chocokiwi0404/audioamp/Project_Report.pdf

# Audio Amplifier Design Report

### Kavya Pandey - 2024102001, Vedant Zope - 2024102003

## Contents

1 Introduction | 3
2 Differential Amplifier (Pre-Amplifier Stage) | 3
3 Common-Emitter (CE) Gain Stage | 10
4 Filter Stage (20 Hz–20 kHz) | 17
5 Power Amplifier Stage | 24

6 Overall Performance and Analysis | 30
7 Conclusion | 32

## 1 Introduction

This project involves the design and construction of a four-stage audio amplifier capable of driving a 10 Ω speaker load with approximately 0.7W of power. The design prioritizes minimal Total Harmonic Distortion (THD) and a flat frequency response within the audible range of 20 Hz to 20 kHz.

## 2 Differential Amplifier (Pre-Amplifier Stage)

### 2.1 Circuit Overview and Purpose

The Pre-amplifier uses a dual-input unbalanced output differential topology. Its primary role is to enhance weak signals (10 mV to 20 mVpp) to line level while maintaining a high Signal-to-Noise Ratio (SNR) and suppressing common-mode noise.

### 2.2 Impedance Finding

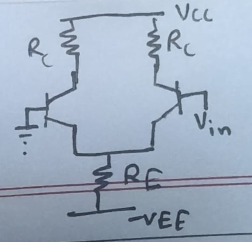
[picture p5: figure]

Figure 1: Circuit diagram

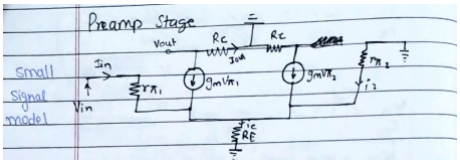
[picture p6: figure]

Figure 2: Small signal model of differential amplifier

The input impedance is defined as

Zin =

Vin

Iin

(1)

From the small signal model,

Iin =

Vin − VE

rπ1

(1)

0 − VE

rπ2

= −I2 | (2)

Assuming

gmvπ1 ≫ I1 | and | gmvπ2 ≫ I2

Then,

VE = gm(vπ1 + vπ2)RE | (2)

Since

vπ = i rπ

we obtain

VE = gmRE(Iin + I2)rπ | (3)

From equation (1),

Iin =

Vin
rπ
− gmRE(Iin + I2) | (4)

From equation (2),

I2 = −

gm(Iin + I2)
RE

(5)

Solving for I2,

I2 = −

gmIinRE
1 + gmRE

(6)

Substituting the value of I2,

Vin
rπ

= Iin
1 + gmIinRE −

gmIinRE
1 + gmIinRE
(7)

Let

α = gmIinRE | and | α ≪ 1

Then,

Vin

Iin

= rπ

1 + α −

α
1 + α
(8)

For α ≪ 1,

Vin

Iin

≈ rπ | (9)

Hence,

Zin = rπ

which is the input resistance.

Output Resistance

Rout =

Vout

Iout
Since

Vout = IoutRC

we obtain

Rout = RC

### 2.3 Gain Derivation

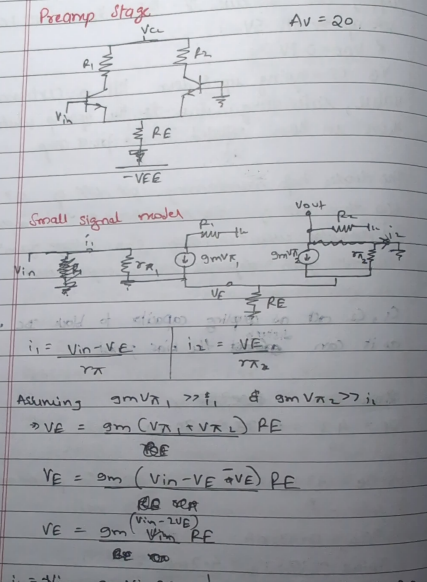
[picture p7: figure]

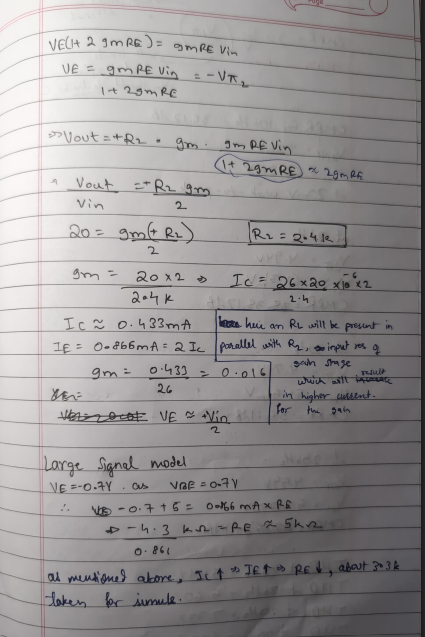
[picture p8: figure]

### 2.4 CMRR and Impedance Analysis

The Common Mode Rejection Ratio (CMRR) is critical for noise immunity:

CMRRabs = gmRE | (10)

With RE = 3.3 kΩ, the theoretical CMRR is 38.4 dB. The input impedance is high (Rin =

2β
gm

), and output impedance is approximately RC.

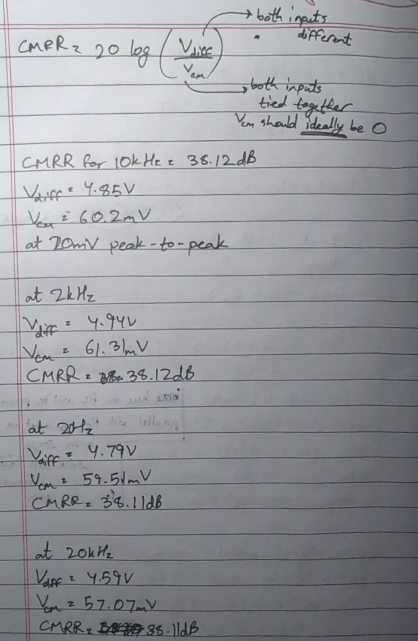
[picture p9: figure]

Figure 3: CMRR values for different frequencies

### 2.5 Simulation Validation

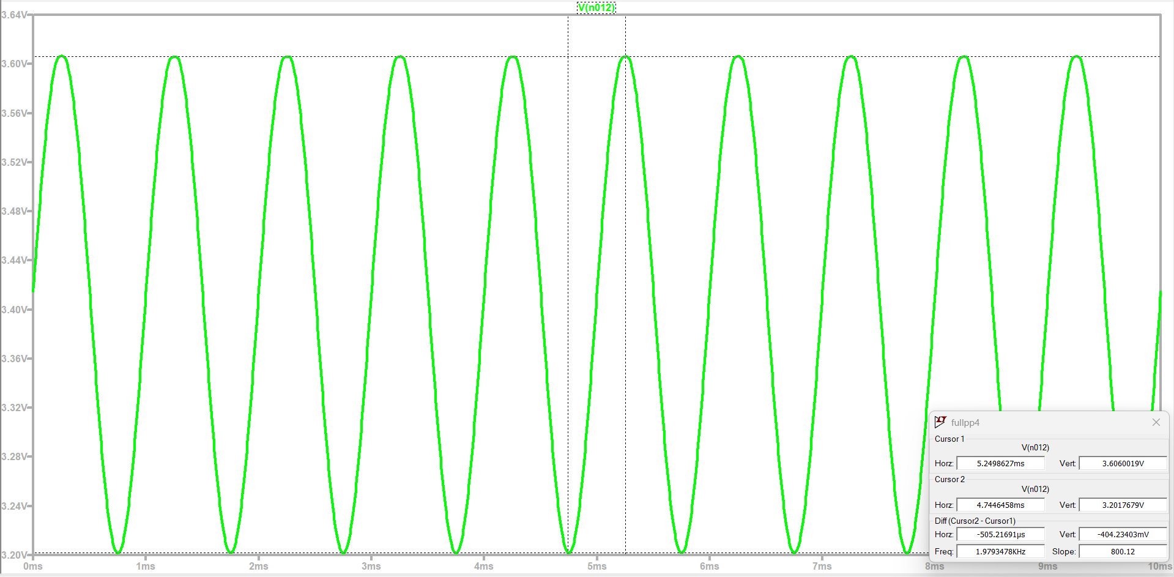
[picture p10: figure]

Figure 4: LTspice transient waveform — Differential Amplifier stage.

### 2.6 Measured LTspice Parameters — Pre-Amplifier

Table 1: LTspice Measured Parameters for Differential Stage

Parameter | Simulated Value
Collector Current (IC1, IC2) | 660 µA
Quiescent Output Voltage (Vout,DC) | 3.41 V
Differential Gain (Ad) | 24.2
Common Mode Gain (Ac) | 60.2
CMRR (Simulated) | 38.12 dB

### 2.7 Hardware Implementation

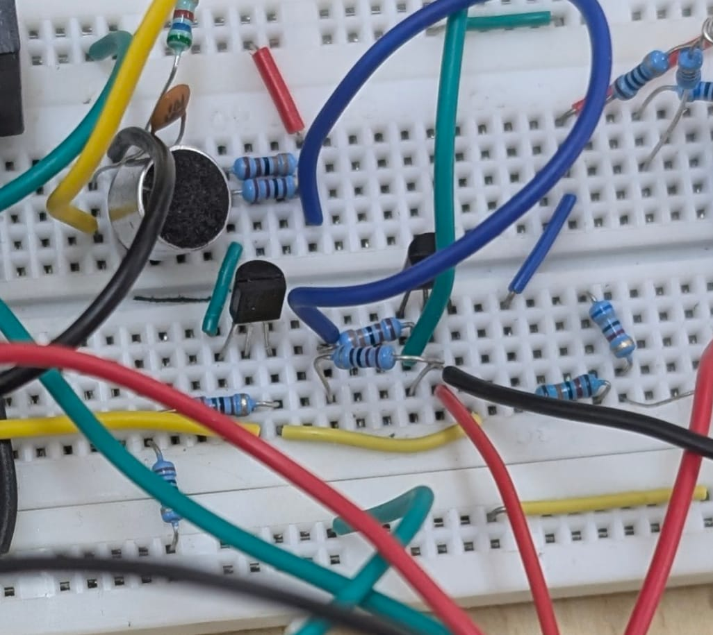
[picture p11: figure]

Figure 5: Hardware circuit of differential amplifier

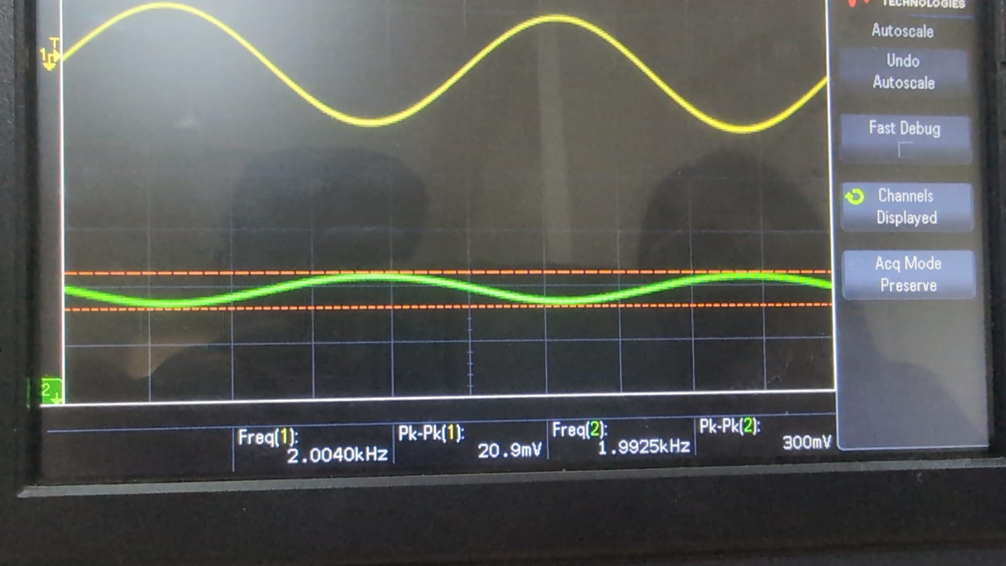
[picture p12: figure]

Figure 6: Waveform

## 3 Common-Emitter (CE) Gain Stage

### 3.1 Purpose and Biasing

The gain stage boosts the signal to a level suitable for the power amplifier. It utilizes voltage divider biasing to ensure the transistor remains in the active region throughout the signal cycle.

### 3.2 Impedence finding

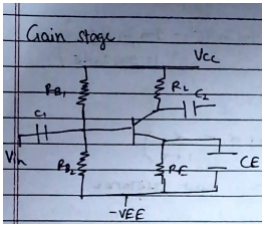
[picture p13: figure]

Figure 7: Circuit digram of Gain stage

### 3.2.1 Output Resistance

To find the output resistance, set the input signal to zero.

Vin = 0

Hence,

gmvπ = 0

Therefore the controlled current source becomes zero and the output current flows only through RL.

Iout =

Vout
RL
Thus,

Rout =

Vout

Iout

= RL

For the given circuit,

Rout = RL

Small Signal Model

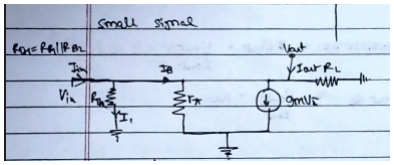
[picture p14: figure]

Figure 8: Small signal model

RT h = RB1 ∥ RB2

Current through RT h:

I1 =

Vin

RT h
Base current through rπ:

I2 =

Vin
rπ
Total current entering the node is

I = I1 + I2

I =

Vin

RT h

+

Vin
rπ

Input Resistance of Gain Stage

The input resistance is

Rin = RB1 ∥ RB2 ∥ rπ

Since

rπ ≫ RB1, RB2

we approximate

Rin ≈ RB1 ∥ RB2

RB1 ∥ RB2 =

RB1RB2

RB1 + RB2
From the design,

RB1RB2

RB1 + RB2

≈ 10RE (from preamp condition)

Given

RB1RB2

RB1 + RB2

≈ 50 kΩ

### 3.3 Small-Signal Gain Derivation

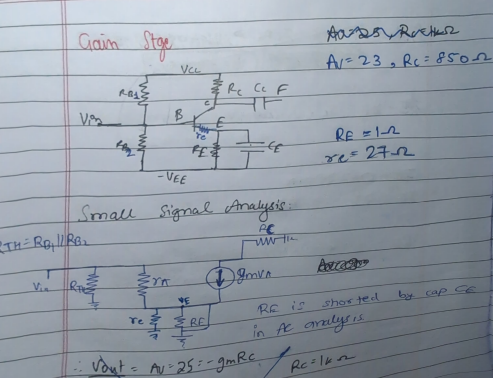
[picture p15: figure]

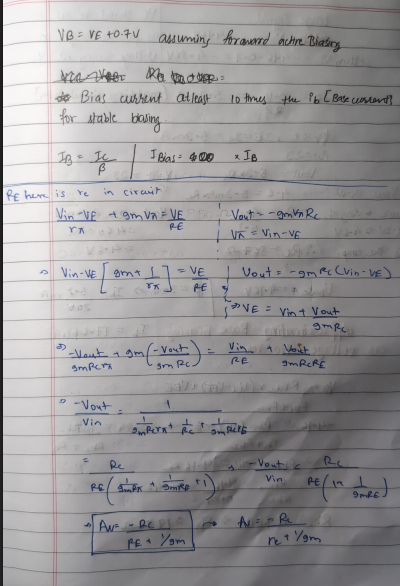
[picture p16: figure]
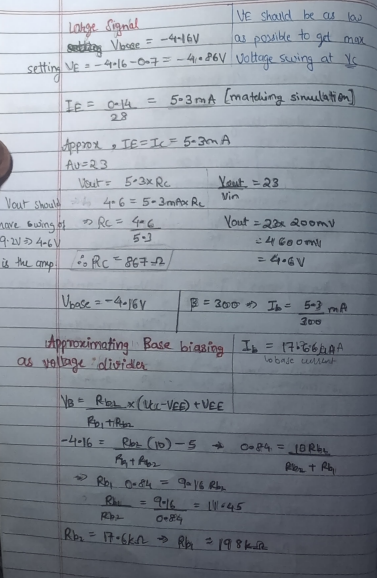
[picture p17: page 15]

### 3.4 Integration and Verification with Stage 1

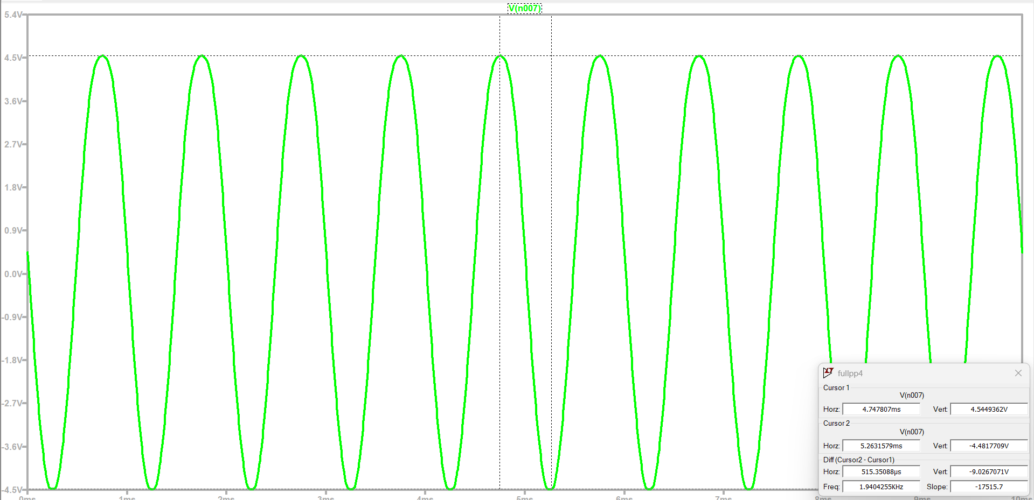
[picture p18: figure]

Figure 9: LTspice waveform — Stages 1 & 2 cascaded output.

### 3.5 Measured LTspice Parameters — CE Stage

Table 2: LTspice Measured Parameters for Gain Stage

Parameter | Simulated Value
Base Voltage (VB) | −4.16 V
Collector-Emitter Voltage (VCEQ) | 5.31 V
Collector Quiescent Current (ICQ) | 5.35 mA
Voltage Gain (Av) | 26 dB
Input Impedance (Zin) | 15.63 kΩ

### 3.6 Hardware Implementation

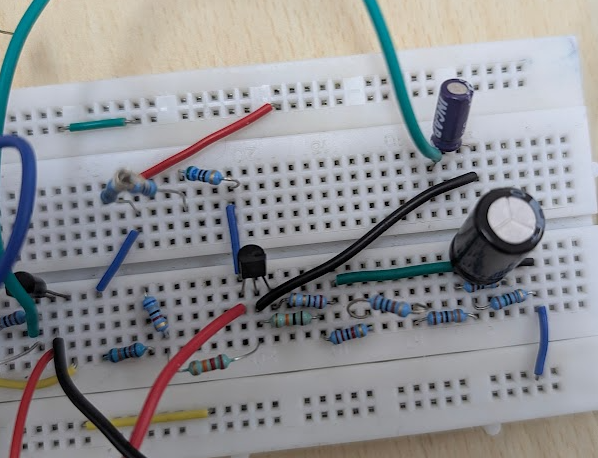
[picture p19: figure]

Figure 10: Hardware circuit for gain stage

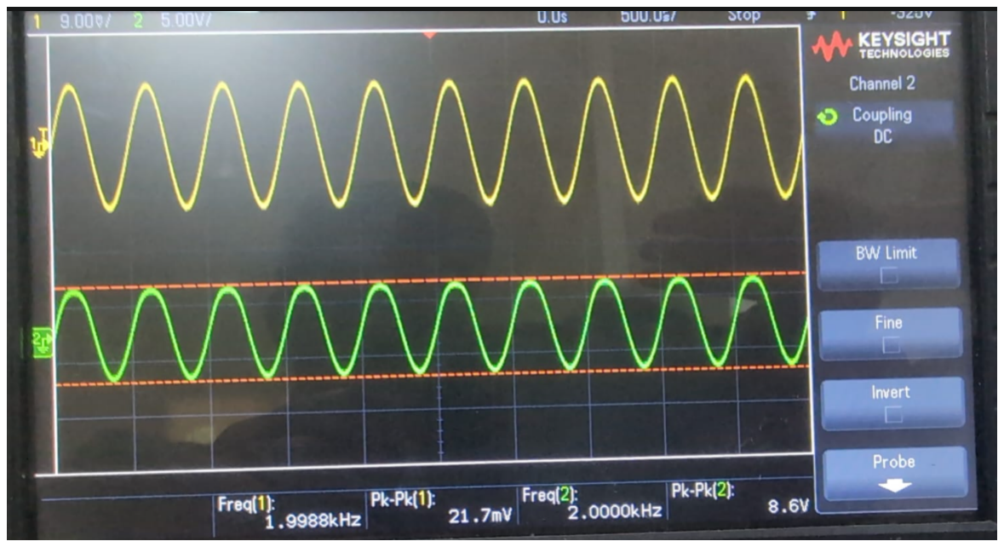
[picture p20: figure]

Figure 11: Waveform

## 4 Filter Stage (20 Hz–20 kHz)

### 4.1 Active Band-Pass Implementation

An active filter is used to maintain signal strength while eliminating low-frequency hum and high-frequency interference. A second-order filter was created by cascading two first-order stages to achieve a steeper roll-off.

### Input and Output Impedence

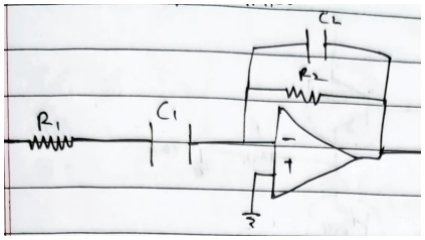
[picture p21: figure]

Figure 12: Circuit diagram for the active bandpass filter

The input resistance of the bandpass filter is

Rin = R1 +

1
jωC1
Since R1 and C1 form a high-pass filter, the cutoff frequency is

fc =

1
2πR1C1
For operating frequencies much higher than the cutoff frequency,

1
jωC1

≪ R1

Hence,

Rin ≈ R1

To find the output resistance,

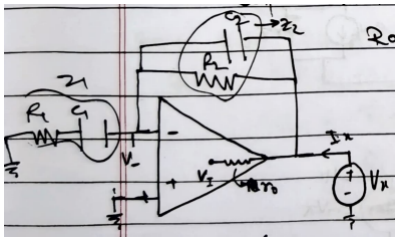
[picture p22: figure]

Figure 13: Circuit diagram to find output impedence

Rout =

Vx
Ix
Assume the op-amp has a finite open-loop gain

Av ≈ 10⁵ − 10⁶

The output resistance of the op-amp itself is very small,

ro ≈ 100 Ω

Let

Z1 =

Z1Z2
Z1 + Z2
The node voltage at the inverting input is

V− = Vx

Z1
Z1 + Z2

(11)

Since the non-inverting terminal is grounded,

V+ = 0

The internal op-amp voltage is

Vo = Av(V+ − V−)

Vo = −AvVx

The test current becomes

Ix =

Vx
Z1 + Z2

+

Vx − Vo
ro

(12)

Substituting Vo,

Ix =

Vx
Z1 + Z2

+

Vx(1 + Av)
ro

(13)

Thus the output resistance becomes

Rout =

Vx
Ix

Rout ≈

ro
1 + Av
Since

Av ≫ 1

Rout ≈

ro
Av
For typical values

ro ≈ 100 Ω, Av ≈ 10⁵

Rout ≈ 10⁻³ Ω

Thus the output resistance of the active bandpass filter is extremely small.

### 4.2 Transfer Function

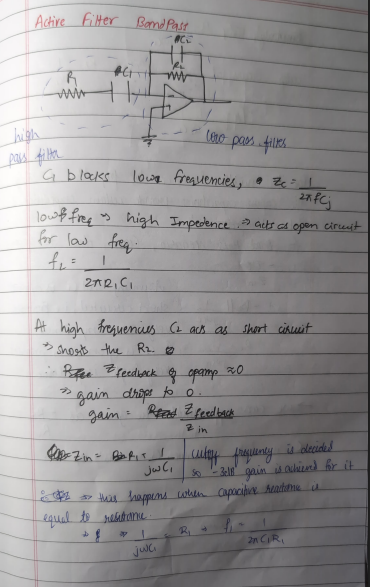
[picture p23: figure]

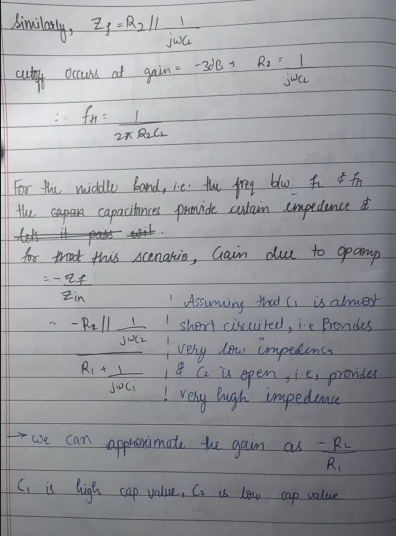
[picture p24: figure]
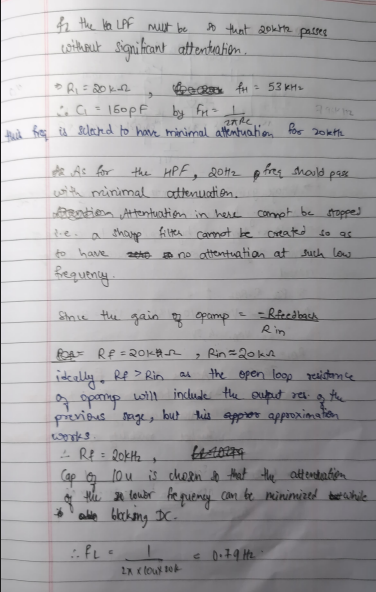
[picture p25: page 22]

### 4.3 Bode Plot and Gain Analysis

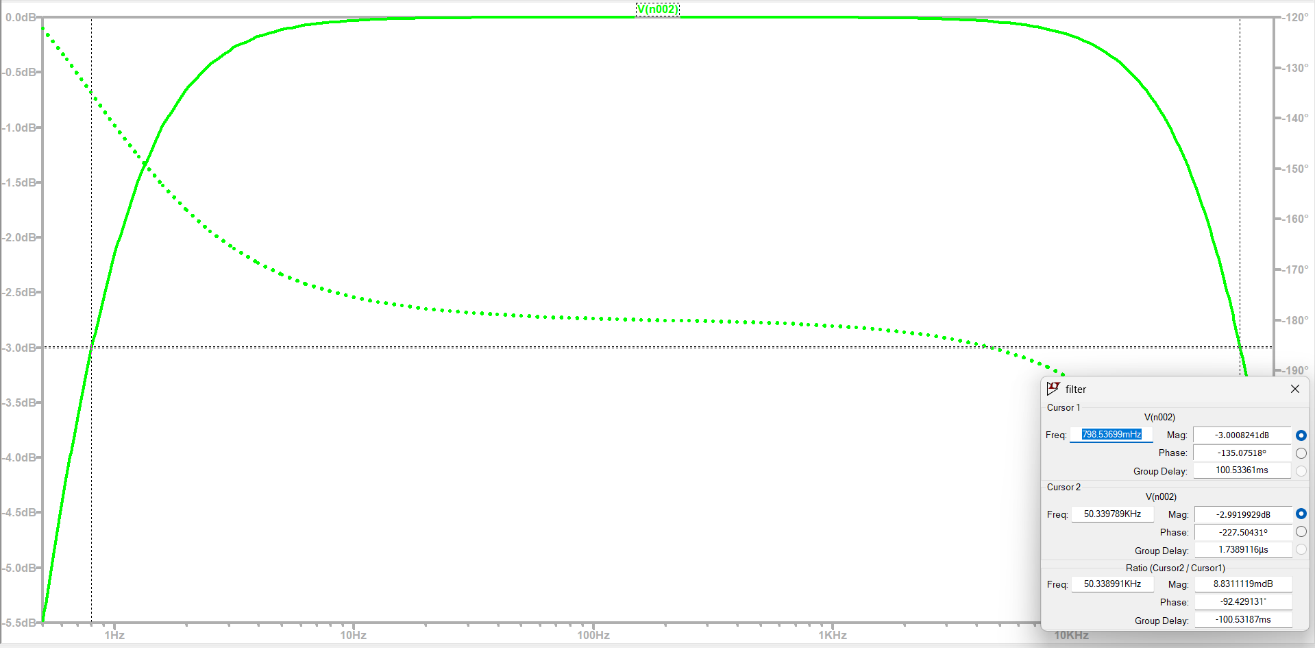
[picture p26: figure]

Figure 14: Bode plot of band-pass filter — 0 dB passband from 20 Hz to 20 kHz.

### 4.4 Measured LTspice Parameters — Filter Stage

Table 3: LTspice Frequency Response Data

Parameter | Simulated Value
Lower Cutoff Frequency (fL) | 0.8 Hz
Upper Cutoff Frequency (fH) | 50.3 kHz
Mid-band Gain | 0 dB

### 4.5 Hardware Implementation

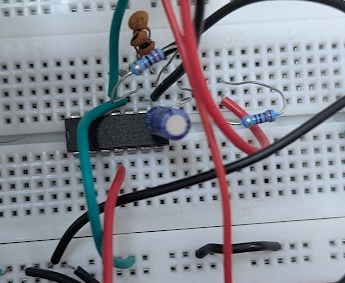
[picture p27: figure]

Figure 15: Active bandpass filter hardware

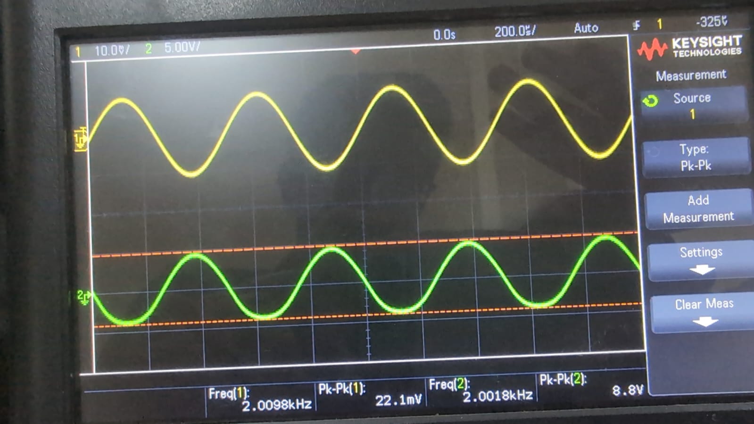
[picture p28: figure]

Figure 16: waveform

## 5 Power Amplifier Stage

### 5.1 Class AB Configuration

A Class AB push-pull configuration is utilized to drive the speaker load efficiently while eliminating crossover distortion. Diode-biasing is employed to keep the output transistors slightly ”ON” even without an input signal.

### 5.2 Power and Efficiency

The stage is designed to drive a 10 Ω load with a peak voltage swing approaching the ±5 V rails. It provides significant current gain (approx. 20) while maintaining a voltage gain of nearly unity.

### 5.3 Input and Output Impedence

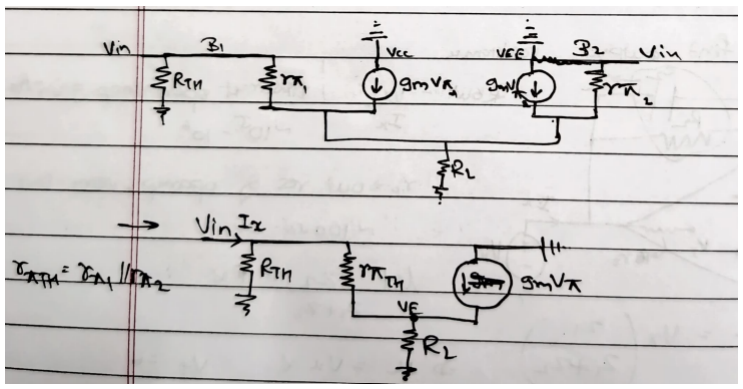
[picture p29: figure]

Figure 17: Small Signal Analysis of power amplifier

For small signal analysis,

VB1 = VB2

Hence there is no potential difference across the bias resistances. Therefore the Thevenin resistance of the bias network is

RT H = R1 ∥ R2

Small Signal Analysis

The current through the Thevenin resistance is

Ix =

Vin

RT H
The base-emitter voltage is

Vπ = Vin − VE

The emitter voltage is related to the emitter current through the load resistor RL.

VE = RLIE

The emitter current consists of the transistor current components

IE = gmVπ +

Vπ
rπ
Substituting Vπ,

VE = RL

gm +

1
rπ
(Vin − VE)

Solving for VE,

VE =

RL

gm +

1
rπ
Vin

1 + RL

gm +

1
rπ

Substituting this into the input current expression,

Ix =

Vin

RT H

+

Vin
rπ

1

1 + RL

gm +

1
rπ

Thus,

Ix =

Vin
RT
where

RT = RT H ∥ (rπ + RL (gmrπ + 1))

Base Resistance due to Transistors

Looking into the emitter,

IE = (β + 1)IB

Thus the resistance seen at the base is

RB = (β + 1)RE

Including the emitter resistance re,

RB = (β + 1)(RL + re)

Since only one transistor conducts at a time in the push-pull configuration,

RB ≈ (β + 1)(RL + re)

Input Resistance

The input resistance of the power amplifier is

Rin = R1 ∥ R2 ∥ RB

Substituting RB,

Rin = R1 ∥ R2 ∥ (β + 1)(RL + re)

Output Resistance

Rout = RL

### 5.4 Derivations

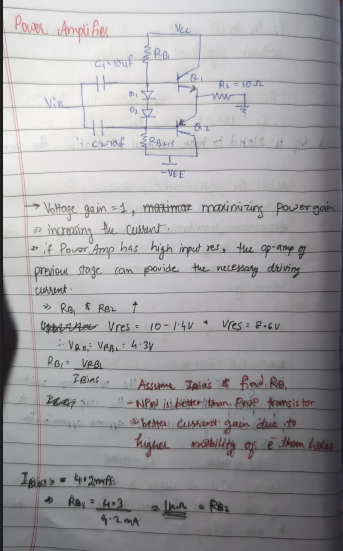
[picture p30: figure]

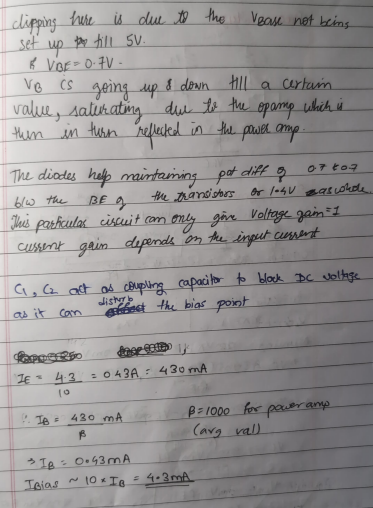
[picture p31: figure]

### 5.5 LTspice Simulation Analysis

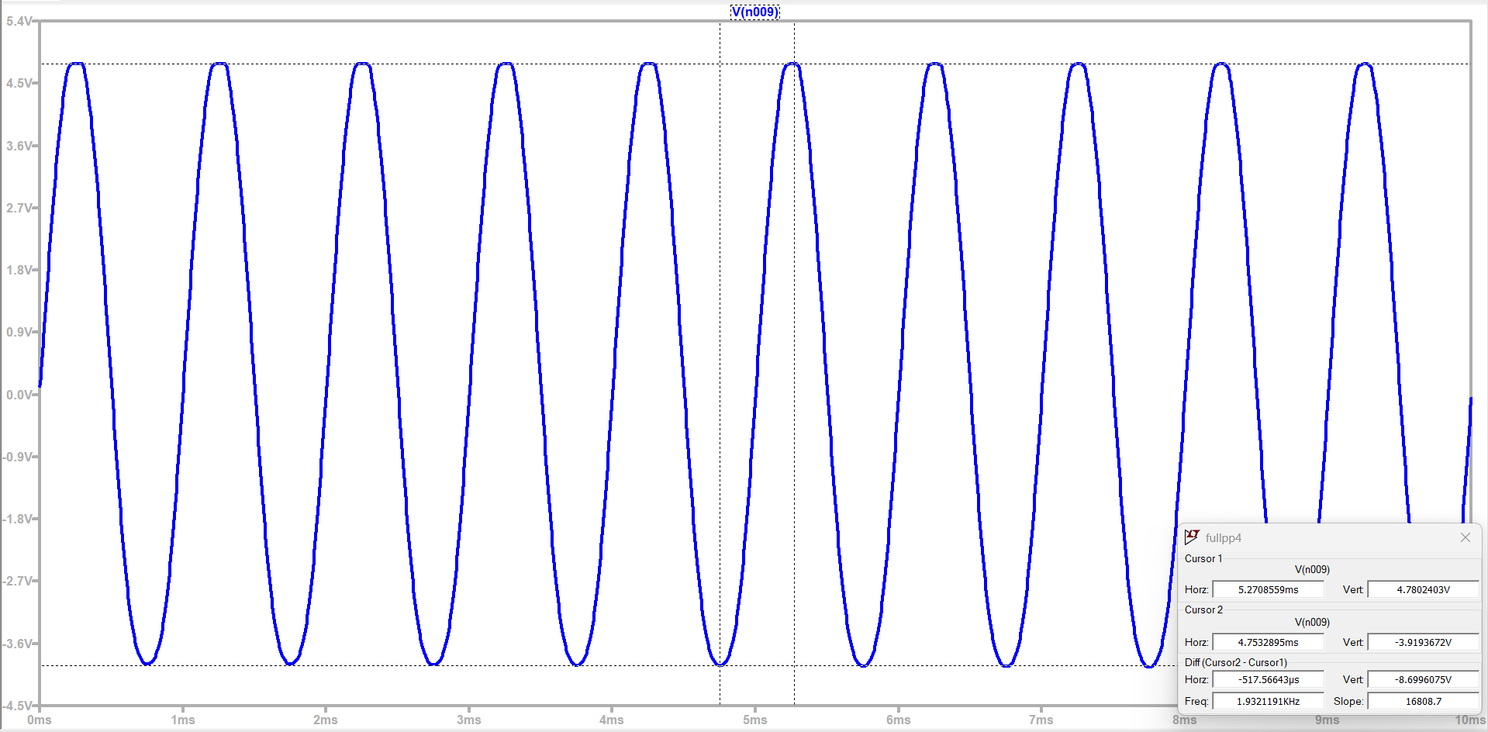
[picture p32: figure]

Figure 18: LTspice analysis of Power Stage — Output voltage swing and crossover check.

### 5.6 Measured LTspice Parameters — Power Stage

Table 4: LTspice Measured Parameters for Class AB Stage

Parameter | Simulated Value
Quiescent Current (IQ) | −12.3 mA
Maximum Peak Voltage Swing | 9.2 V
Voltage Gain (Av) | ≈ 1
Output Power (Pout) | 1.05W

### 5.7 Hardware Implementation

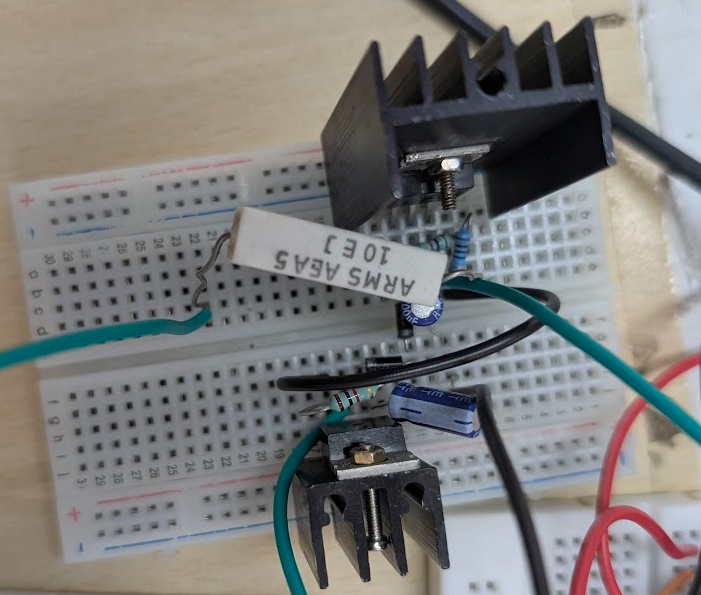
[picture p33: figure]

Figure 19: Power amplifier hardware

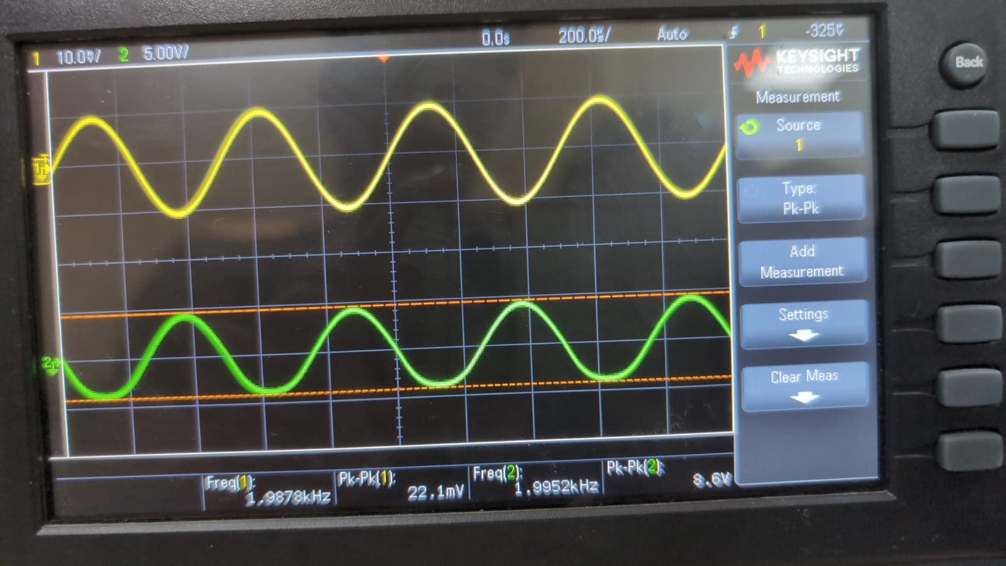
[picture p34: figure]

Figure 20: Waveform

## 6 Overall Performance and Analysis

### 6.1 Final Gain Verification

### 6.1.1 AC Analysis

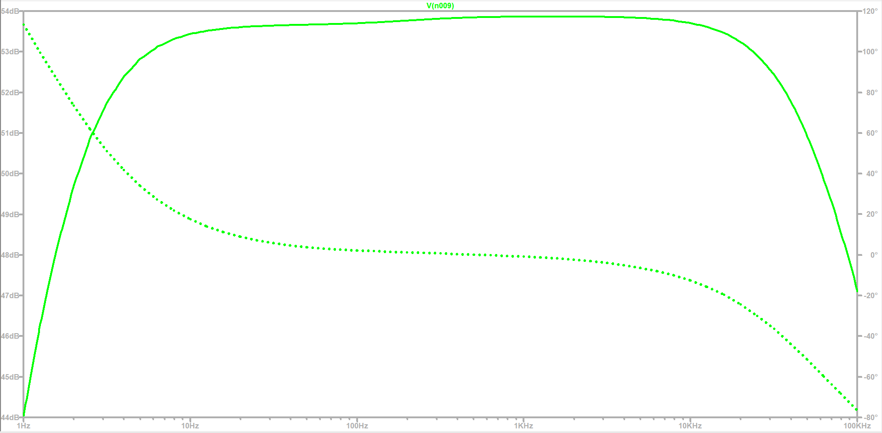
[picture p35: figure]

Figure 21: AC analysis — overall gain vs. frequency (LTspice).

Table 5: Overall AC Performance (LTspice)

Metric | Value
Total Mid-band Gain | 53.86 dB
System Bandwidth | 2.3 Hz - 56.8 kHz
Phase Margin | 179.99◦

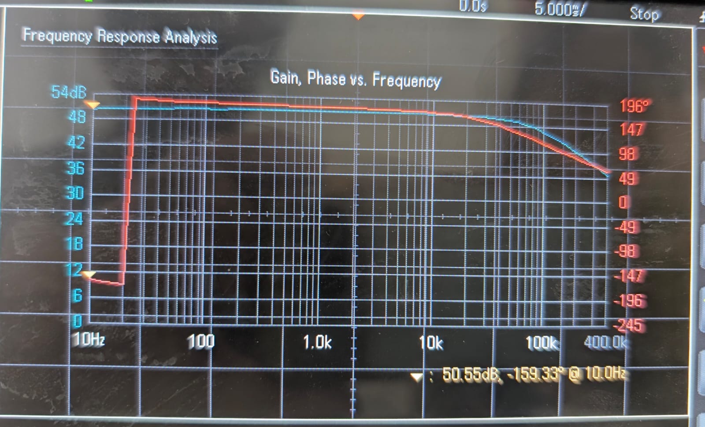
[picture p36: figure]

Figure 22: Frequency Analysis of Hardware

### 6.1.2 Transient Analysis

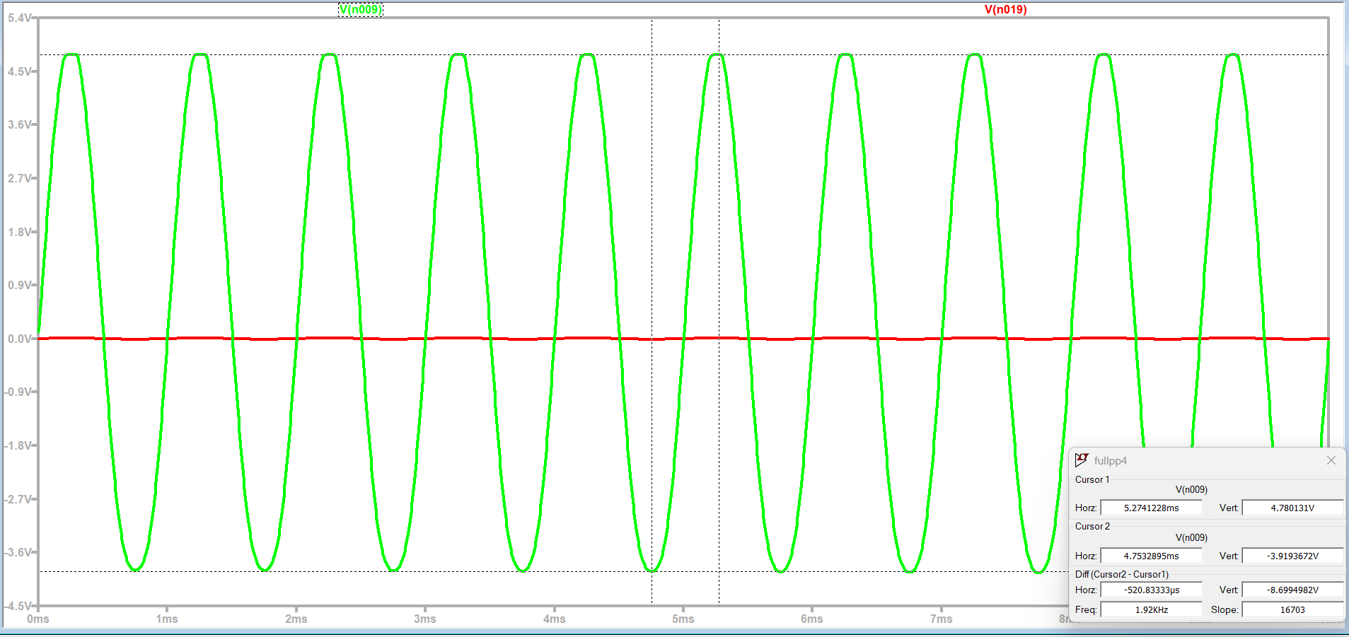
[picture p37: figure]

Figure 23: Transient analysis — input vs. output waveform (LTspice and real circuit).

Table 6: Overall Transient Measurements

Metric | Value
Input Peak-to-Peak | 20 mV
Output Peak-to-Peak | 8.7 V
Voltage Amplification (Linear Range) | 435

### 6.2 Final Gain and THD

The total mid-band gain was measured at 52.04 dB (approx. 400 in absolute terms). THD in hardware was found to be 5.24 % at 1 kHz, which is acceptable given the non-idealities of breadboard construction.

### 6.3 Slew Rate

The simulated maximum slew rate was 27.44 kV s⁻¹ , supporting a distortion-free frequency up to 436.72 kHz for a 10 mV input.

## 7 Conclusion

The design successfully integrated four distinct stages to drive an audio speaker. The use of voltage regulators (7805/7905) ensured stable ±5 V rails from a ±12 V source.

Table 7: Summary of Key Performance Metrics

Parameter | Target | Simulation | Hardware
Mid-band Voltage Gain | >500 | 435 (54.85 dB) | 430
Bandwidth (−3 dB) | 20 Hz – 20 kHz 0.8 Hz – 50.3 kHz 0.8 Hz – 50.3 kHz
THD (Hardware) | – | 5.65 % | 6.67 %
Output Power (Sim) | >1.5W | 1.05W | 0.98W

## References

[1] A. Sedra and K. Smith, Microelectronic Circuits, 7th ed., Oxford University Press, 2014.
[2] Analog Devices, LTspice XVII, [Online]. Available: https://www.analog.com/en/design-center/design-tools-and-calculators/ltspice-simulator.html (https://www.analog.com/en/design-center/design-tools-and-calculators/ltspice-simulator.html)
