chocokiwi0404/audioamp/differential amp/preamp.asc

Q1: npn; BC547B
Q2: npn; BC547B
R1: res; 2.4k
R2: res; 2.4k
R3: res; 3.3k
V1: voltage; 5
V2: voltage; -5
V3: voltage; SINE(0 10m 1k); AC 1
Named nets: 0
.tran 10m
