chocokiwi0404/audioamp/filter/filter.asc

C1: cap; 10µ
C2: cap; 150p
R1: res; 20k
R2: res; 20k
U1: opamp2; UA741
V1: voltage; -12
V2: voltage; 12
V3: voltage; SINE(0 4.5 10k); AC 1
Named nets: 0
.inc C:\\Users\\kavya\\Documents\\LTspiceXVII\\lib\\sub\\UA741.301
.ac dec 10 0.5 70k
