chocokiwi0404/audioamp/full circuit/fullpp4.asc

C1: cap; 100µ
C2: cap; 800µ
C3: cap; 10µ
C4: cap; 150p
C5: cap; 100µ
C6: cap; 100µ
D1: diode; 1N4148
D2: diode; 1N4148
Q1: npn; BC547B
Q2: npn; BC547B
Q3: npn; BC547B
Q4: npn; Qtip31a
Q5: pnp; Qtip32a
R1: res; 2.4k
R2: res; 2.4k
R3: res; 3.3k
R4: res; 140k
R5: res; 850
R6: res; 17.6k
R7: res; 1
R8: res; 20k
R9: res; 20k
R10: res; 27
R11: res; 1k
R12: res; 1k
R13: res; 10
U1: opamp2; UA741
V1: voltage; 5
V2: voltage; -5
V3: voltage; SINE(0 10m 1k); AC 1
V4: voltage; -12
V5: voltage; 12
V6: voltage; 5
V7: voltage; -5
V8: voltage; 0
Named nets: 0
.ac dec 10 1m 70k
.inc C:\\Users\\kavya\\Documents\\LTspiceXVII\\lib\\sub\\UA741.301
.inc "C:\\Users\\kavya\\Documents\\LTspiceXVII\\lib\\sub\\tip31a.lib"
.inc "C:\\Users\\kavya\\Documents\\LTspiceXVII\\lib\\sub\\tip32a.lib"
.four 10k V(N009)
