chocokiwi0404/audioamp/gain stage/gain.asc

C1: cap; 100µ
C2: cap; 100µ
C3: cap; 1000µ
Q3: npn; BC547B
R1: res; 27
R4: res; 140k
R5: res; 841
R6: res; 17.6k
R7: res; 1
V1: voltage; 0
V2: voltage; 5
V3: voltage; -5
Named nets: 0
.tran 1m
