chocokiwi0404/audioamp/power amp/poweramp.asc

C1: cap; 100µ
C2: cap; 100µ
D1: diode; 1N4148
D2: diode; 1N4148
Q1: npn; Qtip31a
Q2: pnp; Qtip32a
R1: res; 1k
R2: res; 1k
R5: res; 10
V1: voltage; 5
V2: voltage; SINE(0 4.5 10k)
V3: voltage; -5
V4: voltage; 0
Named nets: 0
.inc "C:\\Users\\kavya\\Documents\\LTspiceXVII\\lib\\sub\\tip31a.lib"
.inc "C:\\Users\\kavya\\Documents\\LTspiceXVII\\lib\\sub\\tip32a.lib"
.tran 1m
